Baro-o/Open-Salad-Mix/BOM list & 3D explosion view & Assembling/3D explosion view/opensalad_mix_cad_preliminary_a.png

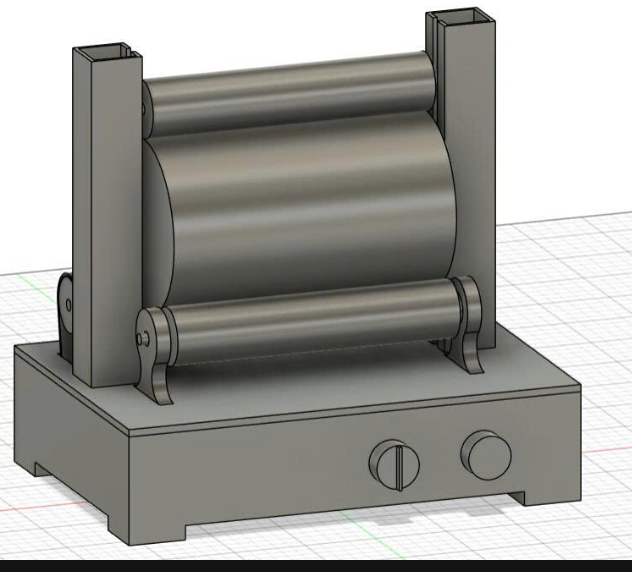
BOM list & 3D explosion view & Assembling/3D explosion view/opensalad_mix_cad_preliminary_a.png
