Baro-o/Open-Salad-Mix/BOM list & 3D explosion view & Assembling/BOM_Open_Salad_Mix_final_v2.pdf

### BOMOpen Salad Mix Rev:08.11.2026 By:Open Salad Mix team Rate:1 EUR = 28,672.48 VND

Part # | 3D view | Part name | Qty | Part size | Material / process / model | Source Type

Unit price
(EUR)

Total
(EUR)
A. 3D-printed parts (FDM)
P001 | Base Housing | 1 | Dimension: 320mm x 220mm x 75mm | Material: PETG / PETG-CF Process: 3D printed (FDM) Note: holes for selector, timer knob and cable | Designed | incl. | incl.
P002 | Deck Plate | 1 | Dimension: 320mm x 220mm x 5.5mm | Material: PETG / PETG-CF Process: 3D printed (FDM) Note: separate part; slots for lower roller position | Designed | incl. | incl.
P003 | Motor Holder | 1 | Dimension: 80mm x 40mm x 49mm | Material: PETG / PETG-CF Process: 3D printed (FDM) | Designed | incl. | incl.
P004 | Lower Bearing Holder | 4 | Dimension: 59mm x 50mm x 10mm | Material: PETG / PETG-CF Process: 3D printed (FDM) Bearing seat for 608-2RS 2 per lower roller | Designed | incl. | incl.
P005 | Upper Bearing Holder (long arm) | 2 | Dimension: 29.5mm x 29.5mm x 152.372mm | Material: PETG / PETG-CF Process: 3D printed (FDM) Note: rests directly on Slider Holder in open position, no separate latch | Designed | incl. | incl.
P006 | Spring Column / Slider Holder | 2 | Dimension: 52mm x 36mm x 225mm | Material: PETG / PETG-CF Process: 3D printed (FDM) Note: covers the extension spring | Designed | incl. | incl.
P007 | Roller Sleeve | 3 | Dimension: Φ40mm x 200mm | Material: TPU 95A Process: 3D printed (FDM) Colour: Green (as in CAD) | Designed | incl. | incl.
P008 | TPU Feet | 4 | Dimension: 42mm x 42mm x 11mm | Material: TPU 95A Process: 3D printed (FDM) Colour: Black | Designed | incl. | incl.
P009 | Control Knob (timer) | 1 | Dimension: Φ40mm x 20mm | Material: PETG / PETG-CF Process: 3D printed (FDM) Note: not listed separately in budget, confirm | Designed | incl. | incl.
P010 | PETG / PETG-CF filament | 1 | Allowance (lot) | For parts 1–6, 9 Supplier: FabLab / local | | 19.18 | 19.18

Part # | 3D view | Part name | Qty | Part size | Material / process / model | Source Type | Unit price (EUR) | Total (EUR)
P011 | | TPU 95A filament | 1 | Approx. 0.5 kg | For parts 7,8 Supplier: FabLab / local | | 7.67 | 7.67
Subtotal A (EUR) | | | | | | | | 26.86
B. Mechanical purchased parts
M001 | Stainless Shaft | 3 | Ø = 8mm L = 240mm / 255mm / 260mm (1 pc each) | Material: Stainless steel Process: cut and deburr | Hardware | 2.96 | 8.89
M002 | Bearing | 6 | Φ22 - Φ8mm Thickness = 7mm | Model: 608-2RS Note: 2 bearings per roller Source: thegioiic.com 608ZZ (metal-shield variant); (https://www.thegioiic.com/608zz-bac-dan-vong-bi-trong-8mm-ngoai-22mm-day-7mm) 2RS | Hardware | 0.84 | 5.02
M003 | GT2 Pulley 20T | 1 | Belt width = 6 Bore: Φ8mm | Mounted on motor Note: verify motor-shaft bore Source: linhkienx.com GT2 20T, 8 mm bore; (https://linhkienx.com/gt2-banh-rang-20-rang-buoc-2mm-truc-8mm-ranh-day-dai-7mm) | Hardware | 0.87 | 0.87
M004 | GT2 Pulley 60T | 1 | Belt width = 6 Bore: Ø8mm | Mounted on driven roller Source: sigmanortec.ro GT2 60T, 8 mm bore; (https://www.sigmanortec.ro/en/toothed-pulley-gt2-60-teeth-8mm) | Hardware | 2.41 | 2.41
M005 | GT2 Endless Belt | 1 | Width = 6mm Circumferenc e = 240mm | Source: no 240 mm closed-loop listing found; closest: thegioiic.com 2GT-280 (280 mm) (https://www.thegioiic.com/2gt-280-day-dai-140-rang-buoc-2-0-rong-6mm) | Hardware | 2.44 | 2.44
M006 | Extension Spring | 2 | Sold as pair | Model: ASRaymond T41270 Note: force and installed length require testing. | Sourced | 6.84 | 13.67
M007 | PET Jar | 2 | Ø120mm Height = 200mm | Material: PET, food contact Incl. cap / seal Note: 1 for the machine + 1 test sample Source: link to be added (no matching listing found yet) | Sourced | 3.49 | 6.98
M008 | Screw (pan-head, coarse thread) | 40 | Ø2.5mm Length = 12mm | Note: 30 required + 10 spare Pull-out test required | Hardware | 0.09 | 3.49
M009 | Misc. hardware set | 1 | Lot | Shaft spacers, set screws, washers, adhesive | Hardware | 4.19 | 4.19
Subtotal B (EUR) | | | | | | | 47.96
C. Electrical parts

Part # | 3D view | Part name | Qty | Part size | Material / process / model | Source Type | Unit price (EUR) | Total (EUR)
E001 | | Controller | 1 | | Model: Arduino Leonardo R3 (ATmega32U4) Source: hshop.vn original board (https://hshop.vn/products/arduino-leonardo-with-headers-chinh-hang-original-made-in-italy) | Hardware | 5.46 | 5.46
E002 | | Rotary Selector | 1 | | Type: 3-speed rotary selector Note: three operating-speed positions | Hardware | 4.19 | 4.19
E003 | | Rotary Timer Switch | 1 | | Type: physical rotary timer switch | Hardware | 6.28 | 6.28
E004 | | Motor | 1 | | Model: JGB37-520, 12 V, with encoder, 176 rpm Source: thegioiic.com JGB37-520 176 rpm (https://www.thegioiic.com/jgb37-520-dong-co-giam-toc-co-encoder-12vdc-176-rpm-truc-6mm) | Hardware | 6.98 | 6.98
E005 | | Motor Controller | 1 | | Model: IBT-2 / BTS7960 Source: thegioiic.com BTS7960 43A module (https://www.thegioiic.com/products/bts7960-module-dieu-khien-dong-co-dc-43a) | Hardware | 4.88 | 4.88
E006 | | Power Supply | 1 | | Model: MEAN WELL GST60A12-P1J 12 V, 5 A, 60 W | Hardware | 17.05 | 17.05
E007 | | Electrical Wire | 1 | L = 2000 | Note: only wire is retained, no connectors | Hardware | 2.44 | 2.44
E008 | | USB Cable | 1 | | For Arduino Leonardo Programming / data cable Source: hshop.vn Micro-USB cable 30 cm (https://hshop.vn/cap-micro-usb-to-usb-a-2-0-cable-30cm) | Hardware | 1.22 | 1.22
E009 | | Resistor 10 kΩ | 2 | 1/4 W, 5 %, axial | Value: 10 kΩ (brown-black-orange) Note: pull-up / pull-down for controller inputs Source: thegioiic.com 10 kΩ 1/4 W 5 % (https://www.thegioiic.com/dien-tro-10-kohm-1-4w-5-4-vong-mau) | Hardware | 0.02 | 0.04
Subtotal C (EUR) | | | | | | | | 48.54
TOTAL (EUR) | | | | | | | | 123.36
Budget (EUR) | | | | | | | | 200.00
Headroom (EUR) | | | | | | | | 76.64

## Reference views (CAD)

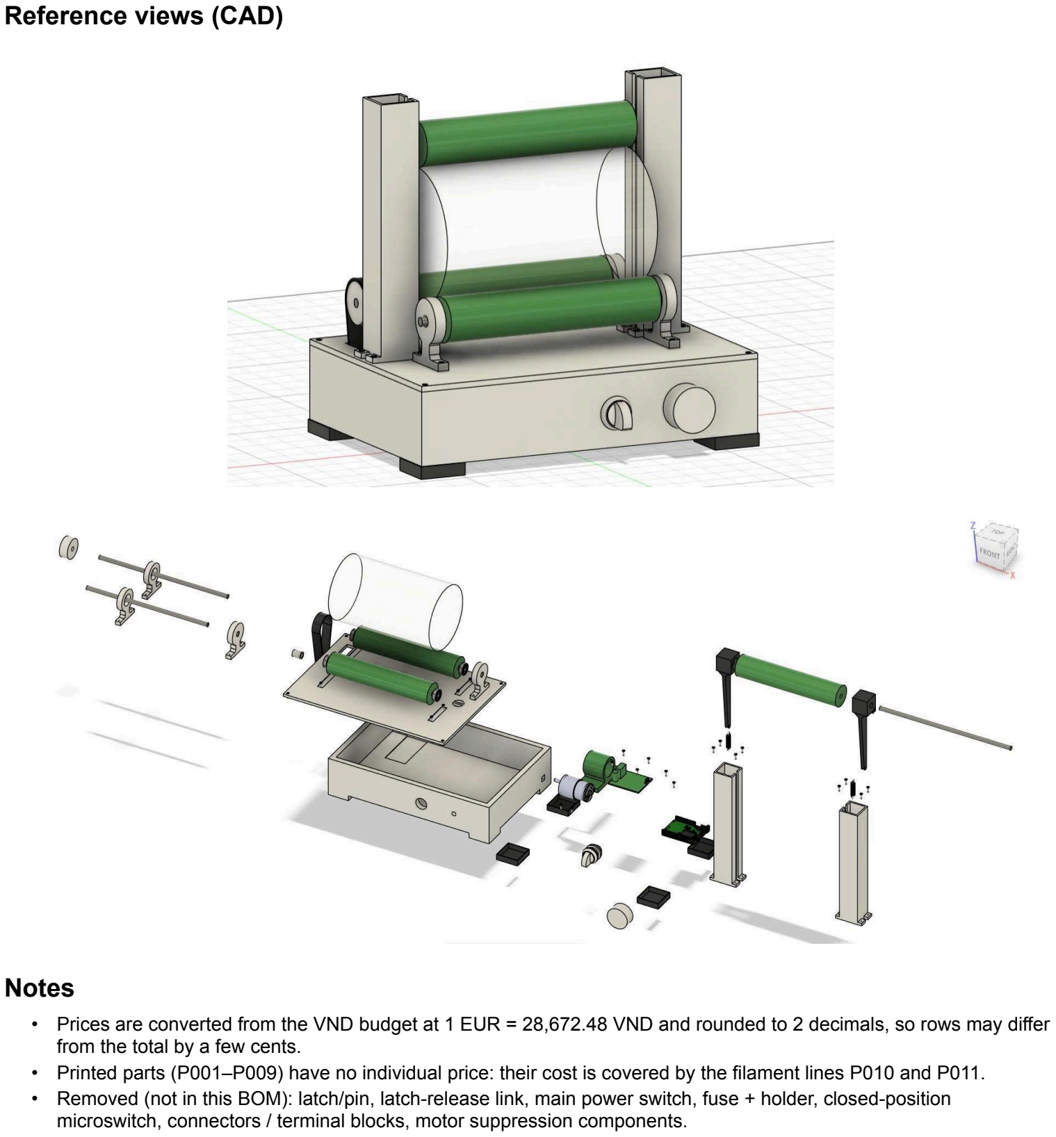
[picture p3: page 4]

## Notes

- Prices are converted from the VND budget at 1 EUR = 28,672.48 VND and rounded to 2 decimals, so rows may differ from the total by a few cents.
- Printed parts (P001–P009) have no individual price: their cost is covered by the filament lines P010 and P011.
- Removed (not in this BOM): latch/pin, latch-release link, main power switch, fuse + holder, closed-position microswitch, connectors / terminal blocks, motor suppression components.
