Baro-o/Open-Salad-Mix/BOM list & 3D explosion view & Assembling/3D explosion view/explore 4.jpg

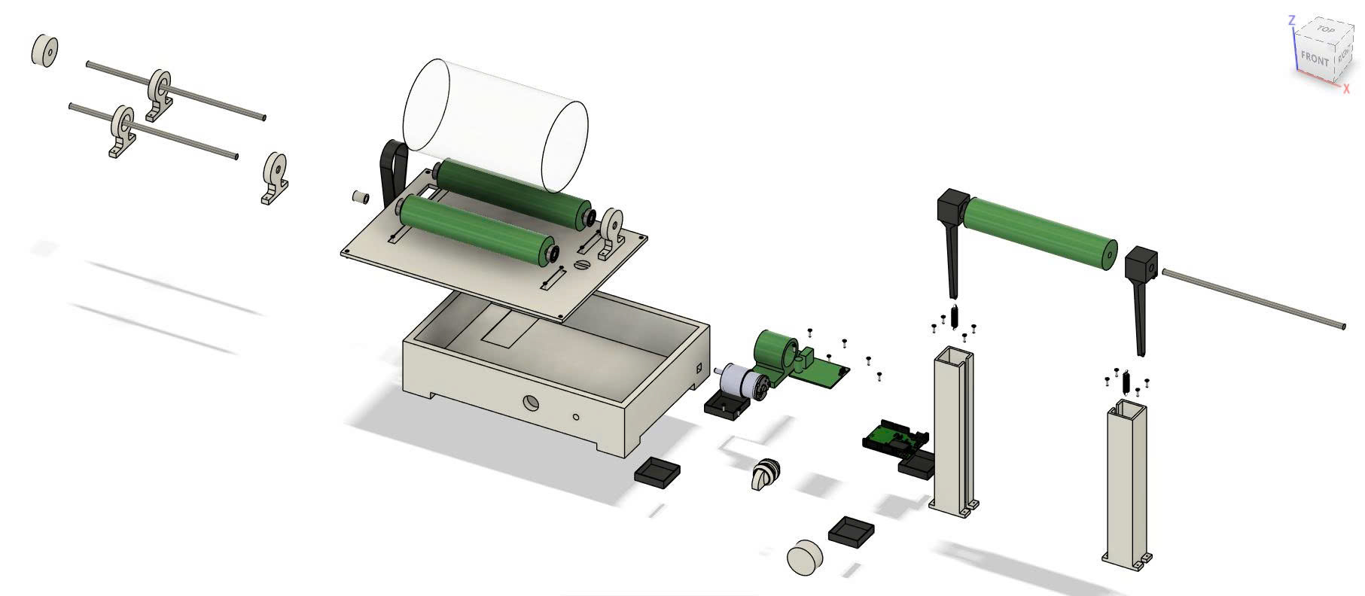
BOM list & 3D explosion view & Assembling/3D explosion view/explore 4.jpg
