Baro-o/Open-Salad-Mix/BOM list & 3D explosion view & Assembling/3D explosion view/explore 6.jpg

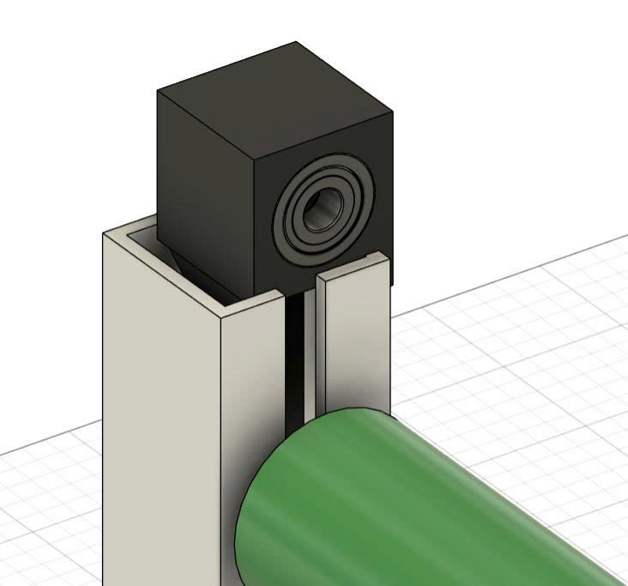
BOM list & 3D explosion view & Assembling/3D explosion view/explore 6.jpg
