Baro-o/Open-Salad-Mix/3D Model/Assembly.step

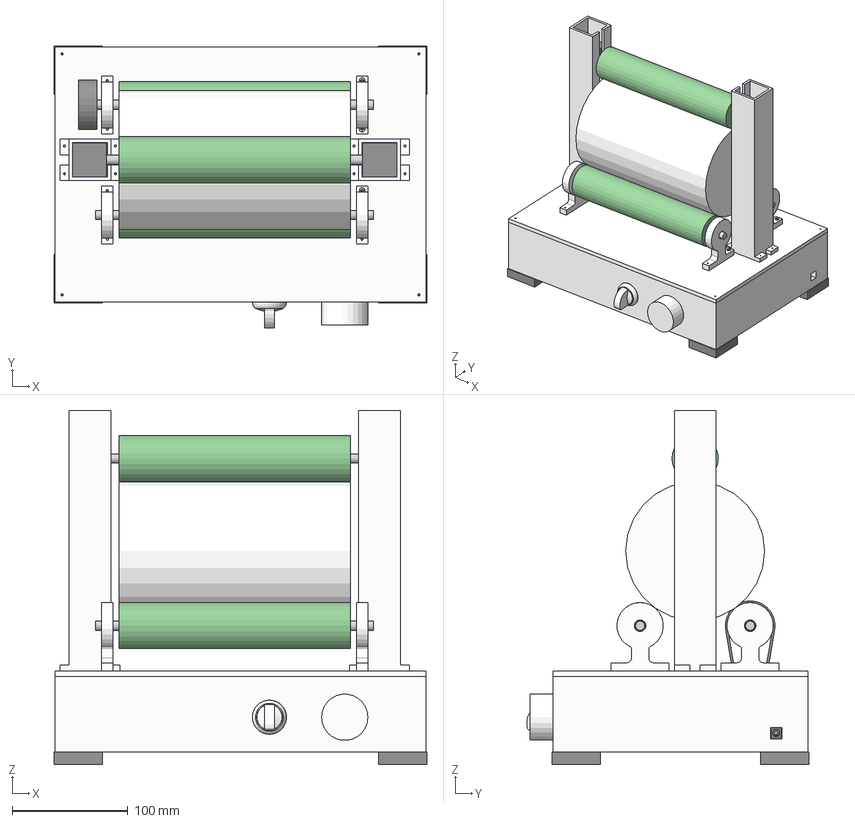
[picture p10: CAD file, 2026-11-08]
3D Model/Assembly.step
322.0 x 243.9 x 306.0 mm
looped_end_extension_spring_t41270
