Baro-o/Open-Salad-Mix/3D Model/3D print file.3mf

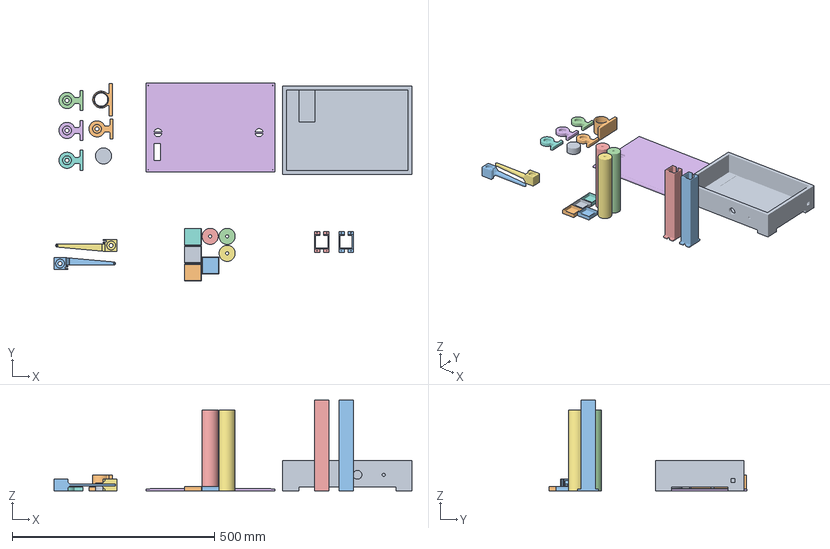
[picture p11: CAD file, 2026-11-08]
3D Model/3D print file.3mf
885.8 x 489.0 x 225.0 mm
Base and Electronic x 7
Clamping Roller Slide x 4
Bottom Roller x 7
OpenSalad Mix
