Baro-o/Open-Salad-Mix/3D Model/3D Print/P001_Base Housing.step

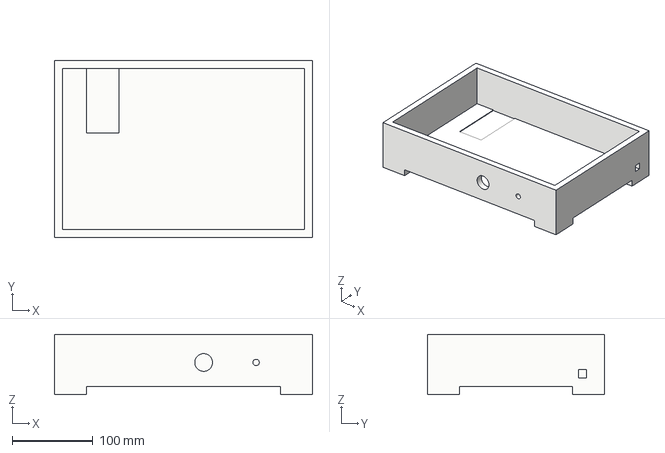
[picture p12: CAD file, 2026-11-08]
3D Model/3D Print/P001_Base Housing.step
320.0 x 220.0 x 75.0 mm
