Baro-o/Open-Salad-Mix/3D Model/Hardware/E001_Arduino Leonardo.step

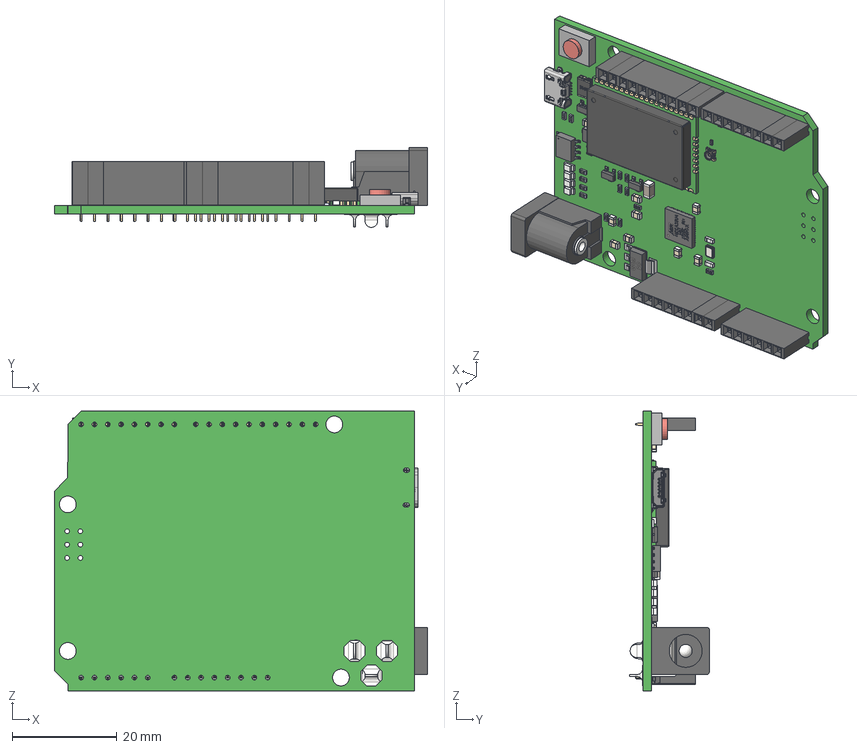
[picture p13: CAD file, 2026-11-08]
3D Model/Hardware/E001_Arduino Leonardo.step
71.1 x 15.2 x 53.3 mm
Extruded (1) x 6
Extruded x 6
Extruded (3)
Extruded (8) x 2
Extruded (9) x 3
Extruded (6) x 3
Extruded (10)
Extruded (13) x 11
User_Library-GeyerElectronics_KX6
Extruded (14)
Extruded (15)
Extruded (19)
Extruded (20) x 4
Extruded (21)
Extruded (2) x 5
Extruded (22)
Extruded (24)
RN2483
Atmega32U4-MU
nano - reg
THE THINGS UNO LED x 4
Arduino_uno_power jack
SOIC8-N_MC_MCH
micro USB
ssot3 x 4
HEADER 6 FEM x 4
HEADERFEMB x 8
Case x 12
Contacts x 12
Mid Body
Mark
R0603 10k ohm x 9
R0603 1k ohm x 4
1812_Fuse
R0603 22RO x 2
212(0805)-0850T x 2
316(1206)-1600T
