Baro-o/Open-Salad-Mix/3D Model/3D Print/P007_Roller Sleeve.step

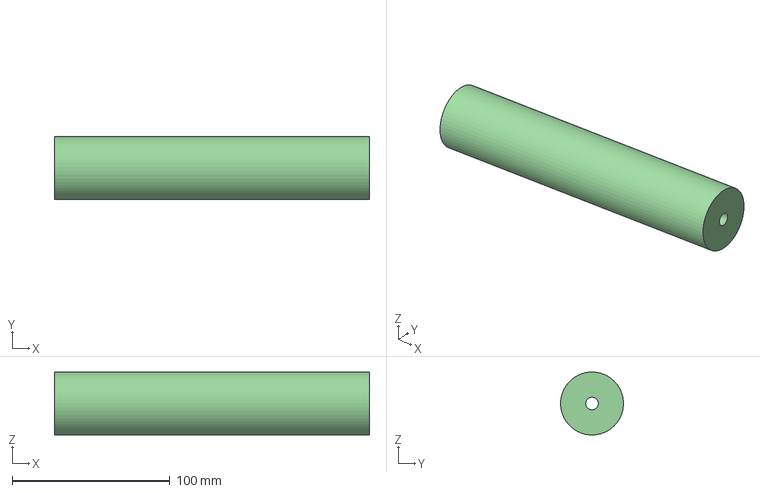
[picture p14: CAD file, 2026-11-08]
3D Model/3D Print/P007_Roller Sleeve.step
200.0 x 40.0 x 40.0 mm
