Baro-o/Open-Salad-Mix/3D Model/3D Print/P005_Upper Bearing Holder.step

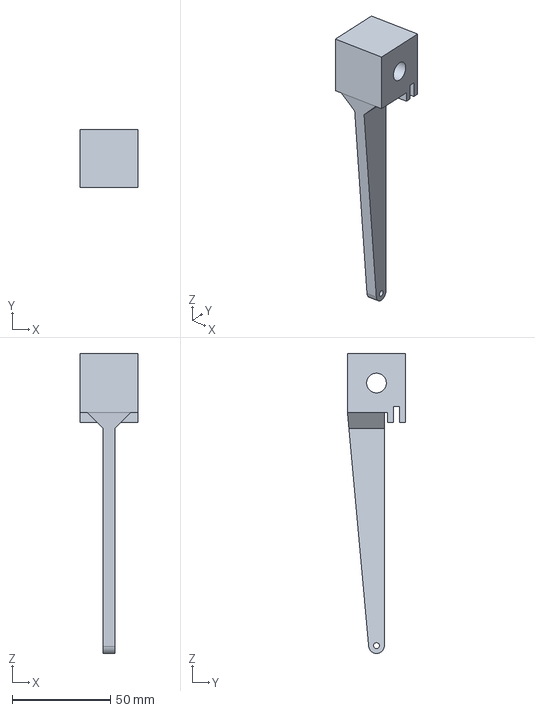
[picture p15: CAD file, 2026-11-08]
3D Model/3D Print/P005_Upper Bearing Holder.step
29.5 x 29.5 x 152.4 mm
