Baro-o/Open-Salad-Mix/3D Model/Hardware/M006_Looped_end_extension_spring_t41270.stp

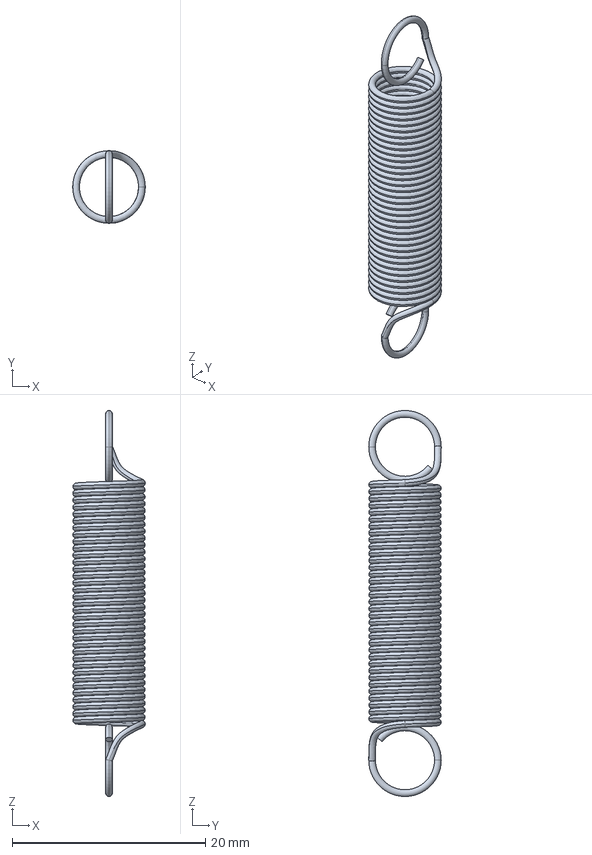
[picture p16: CAD file, 2026-11-08]
3D Model/Hardware/M006_Looped_end_extension_spring_t41270.stp
7.50 x 7.50 x 39.9 mm
