Baro-o/Open-Salad-Mix/3D Model/3D Print/P008_TPU Feet.step

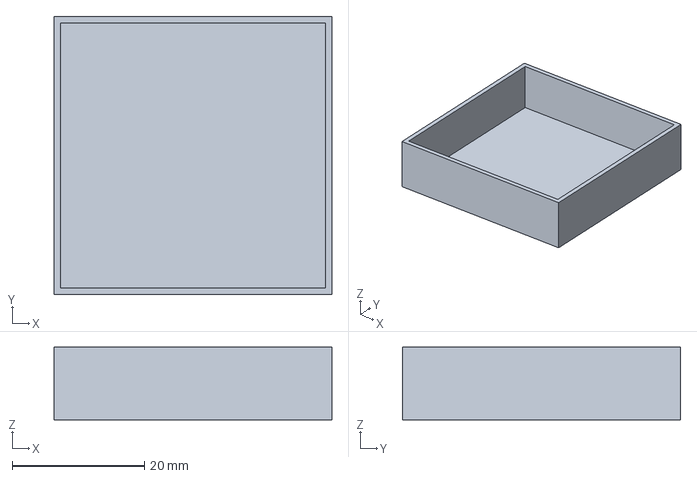
[picture p17: CAD file, 2026-11-08]
3D Model/3D Print/P008_TPU Feet.step
42.0 x 42.0 x 11.0 mm
