Baro-o/Open-Salad-Mix/3D Model/Hardware/M002_Bearing_608_2rs.stp

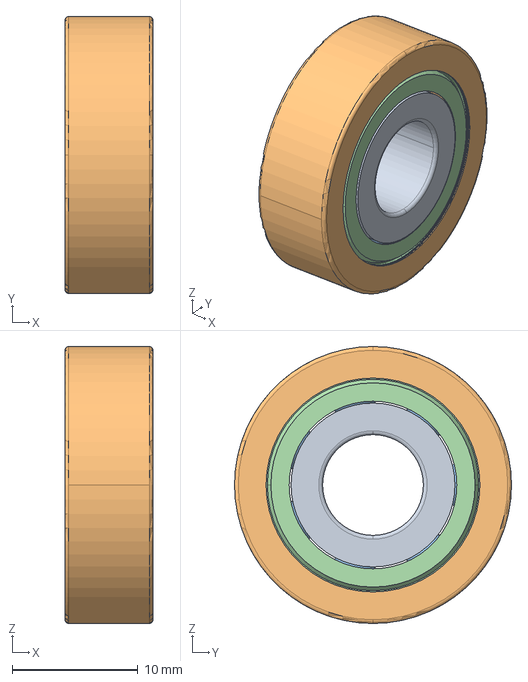
[picture p18: CAD file, 2026-11-08]
3D Model/Hardware/M002_Bearing_608_2rs.stp
7.00 x 22.0 x 22.0 mm
