Baro-o/Open-Salad-Mix/3D Model/3D Print/P009_Physical Rotary Timer Extension Knob.step

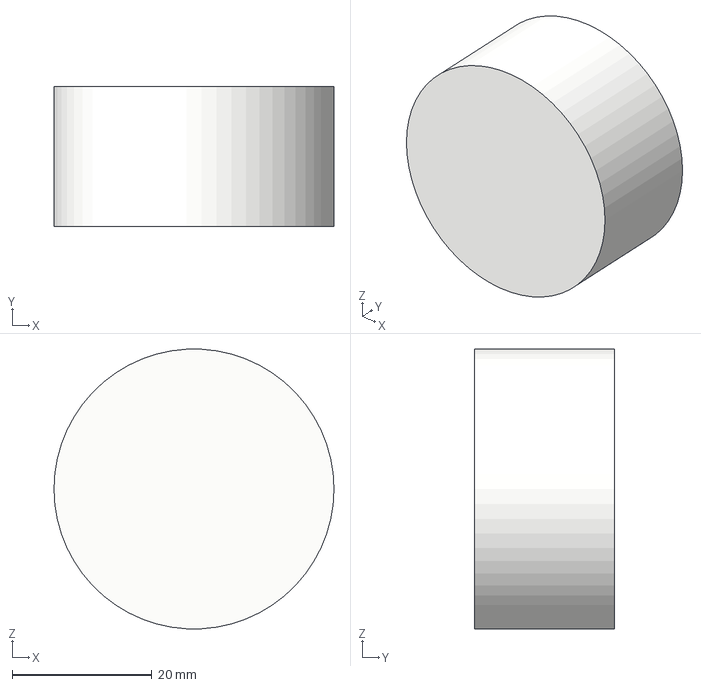
[picture p19: CAD file, 2026-11-08]
3D Model/3D Print/P009_Physical Rotary Timer Extension Knob.step
40.0 x 20.0 x 39.9 mm
