Baro-o/Open-Salad-Mix/3D Model/Hardware/E004_Motor JGB37-520.STEP

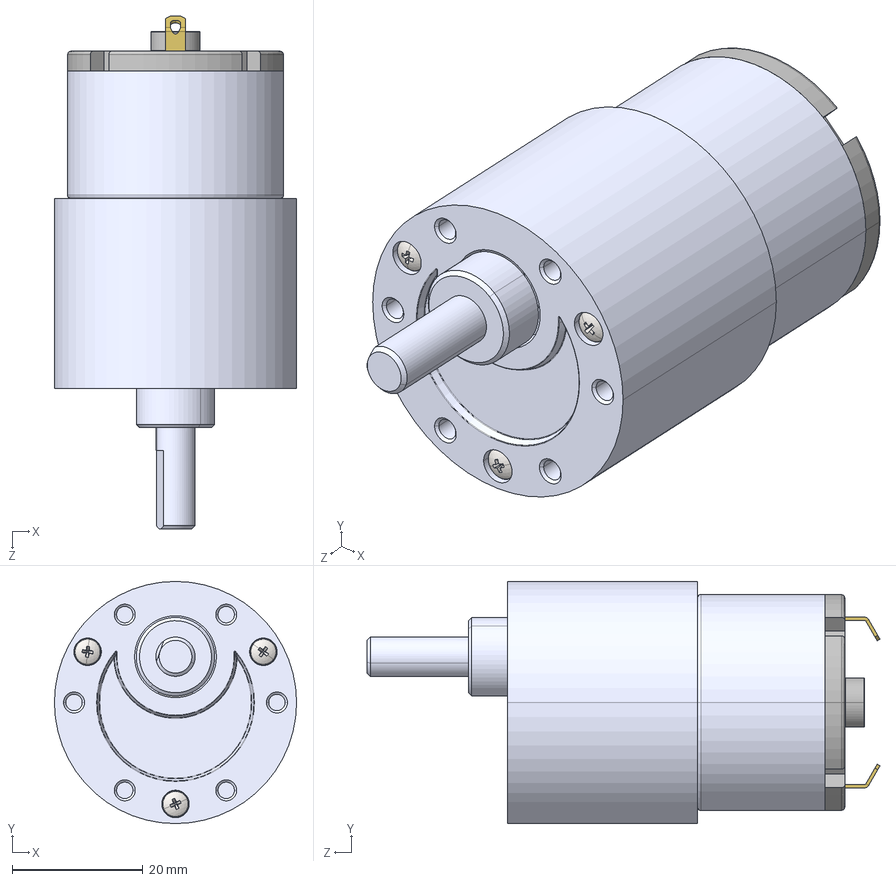
[picture p20: CAD file, 2026-11-08]
3D Model/Hardware/E004_Motor JGB37-520.STEP
37.0 x 37.0 x 78.4 mm
GEARED BODY, MOTOR, JGB37-520
DC MOTOR, JGB37-520
MOTOR SHAFT, JGB37-520
SHAFT COUPLER, JGB37-520
COUPLING BRACKET, GEARED BODY TO DC MOTOR, JGB37-520
PLASTIC COVER, DC MOTOR, JGB37-520
CONNECTION, DC MOTOR, JGB37-520 x 2
pan cross head_am_B18.6.7M - M2 x 0.4 x 25 Type I Cross Recessed PHMS --25N x 3
