Baro-o/Open-Salad-Mix/3D Model/3D Print/P003_Motor Holder.step

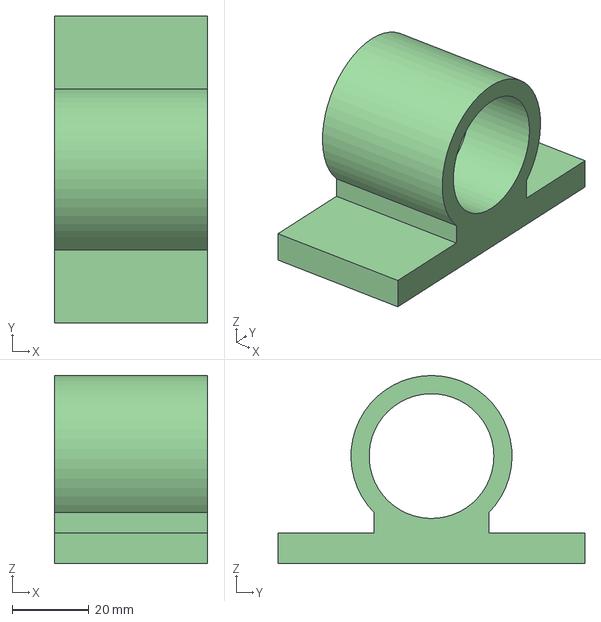
[picture p21: CAD file, 2026-11-08]
3D Model/3D Print/P003_Motor Holder.step
40.0 x 80.0 x 49.0 mm
