Baro-o/Open-Salad-Mix/3D Model/Hardware/E002_3 position Button.stp

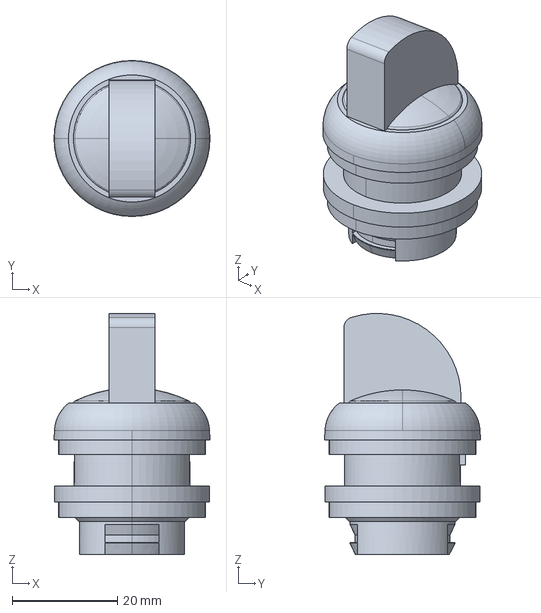
[picture p22: CAD file, 2026-11-08]
3D Model/Hardware/E002_3 position Button.stp
29.7 x 29.7 x 45.9 mm
