Baro-o/Open-Salad-Mix/3D Model/3D Print/P006_Slider Holder.step

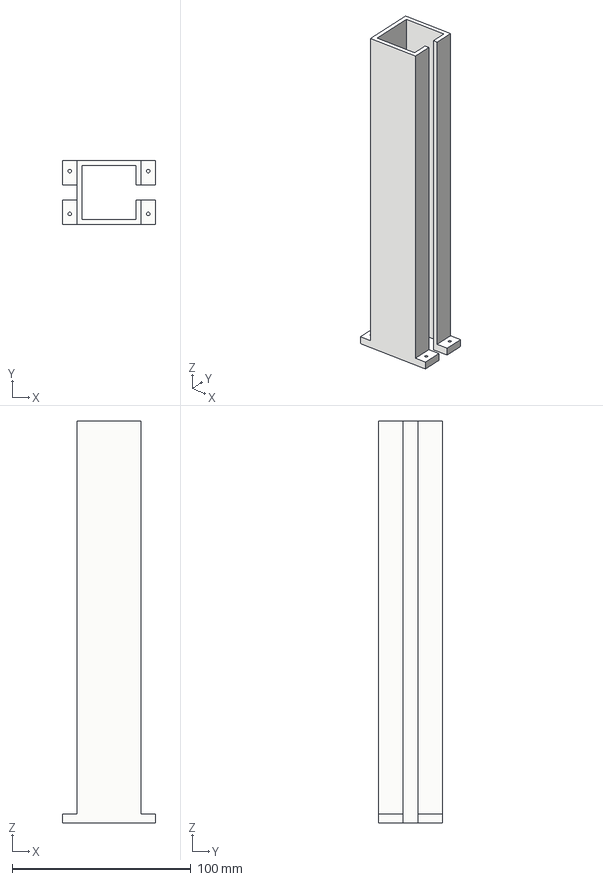
[picture p23: CAD file, 2026-11-08]
3D Model/3D Print/P006_Slider Holder.step
52.0 x 36.0 x 225.0 mm
