Baro-o/Open-Salad-Mix/3D Model/3D Print/P004_Lower Bearing Holder.step

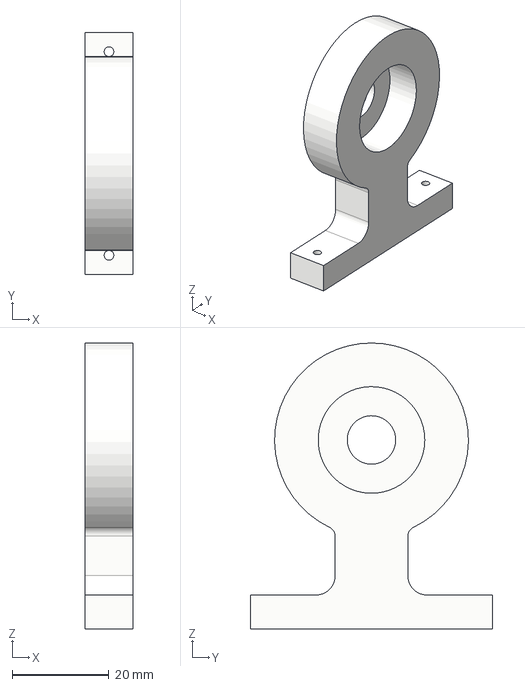
[picture p24: CAD file, 2026-11-08]
3D Model/3D Print/P004_Lower Bearing Holder.step
10.0 x 50.0 x 59.0 mm
