Baro-o/Open-Salad-Mix/3D Model/3D Print/P002_Deck Plate.step

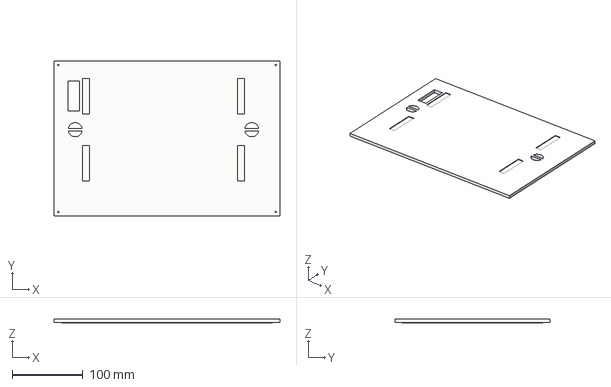
[picture p25: CAD file, 2026-11-08]
3D Model/3D Print/P002_Deck Plate.step
320.0 x 220.0 x 5.50 mm
