Baro-o/Open-Salad-Mix/3D Model/Hardware/M008_Pan Head Screw.stp

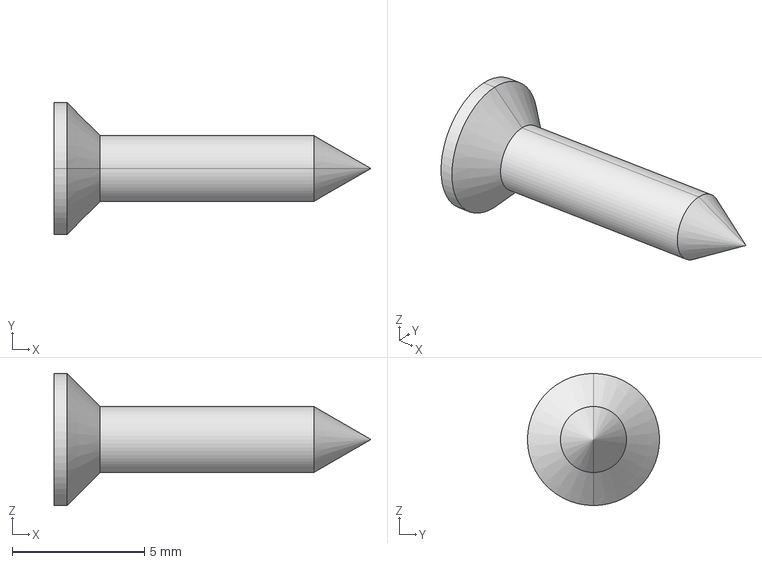
[picture p26: CAD file, 2026-11-08]
3D Model/Hardware/M008_Pan Head Screw.stp
12.0 x 5.00 x 5.00 mm
