Baro-o/Open-Salad-Mix/(list of files, cad)

Other CAD files:
3D Model/Assembly.f3z
