Baro-o/Open-Salad-Mix/Open_Salad_Mix_User_Guide.pdf

## open salad mix

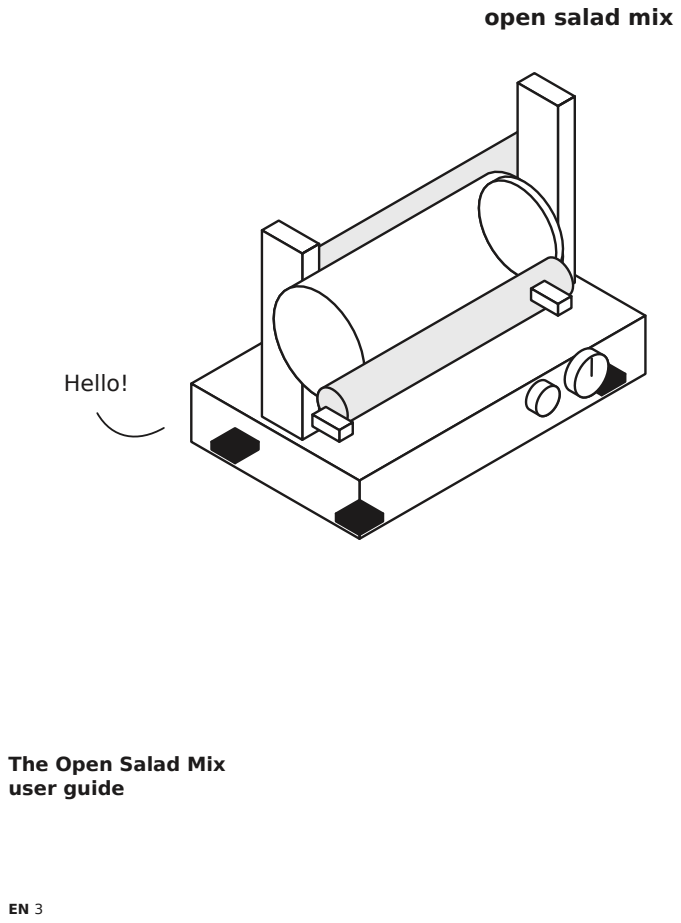
[picture p27: page 1]
Hello!

The Open Salad Mix
user guide

EN | Jar

Table of contents

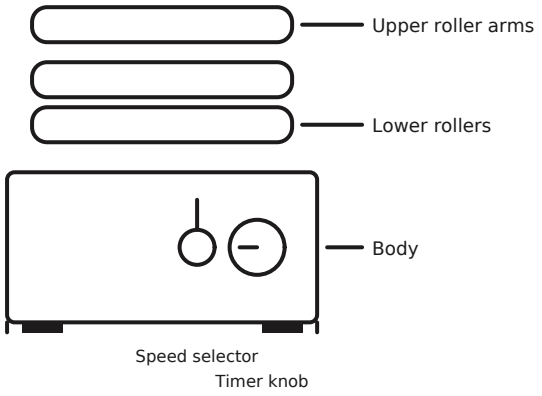
[picture p28: figure]
Upper roller arms; Lower rollers; Body; Speed selector; Timer knob

1. Important safety information | 4
2. Before using Open Salad Mix | 5
3. Using your Open Salad Mix | 7
4. Inside your Open Salad Mix | 12
5. Keeping Open Salad Mix in the loop 13
6. Technical and warranty | 14

IMPORTANT
Please read this user manual carefully before you use the appliance and save it for future reference.

In the box
Body • Jar with lid (PET, food contact) • 12 V power adapter • USB cable (for programming only) • User manual

EN 3

1. Important safety information | !

WARNING
- Always use the appliance in

accordance with these instructions. Improper use can result in electric shocks and other hazards.
- Do not use a jar if you detect cracks,

deep scratches, cloudiness or any damage to the plastic.
- Never fill the jar above the fill line

marked on it or with ingredients hotter than 40 °C, or with carbonated or fermenting ingredients (e.g. baking soda, baking powder, yeast).
- Always close the jar with its lid before

placing it on the rollers.
CAUTION
- Never leave the Open Salad Mix

unattended while it is in use.
- Always unplug the power adapter when

not in use.
- Pinch hazard: keep fingers, hair and

loose clothing away from the rollers, the belt and the upper roller arms while the machine is running.
- Lift and lower the upper roller arms

only when the machine is switched off and has completely stopped.
- Switch off and unplug the appliance

before leaving it unattended, assembling, disassembling or cleaning it.

Intended use
and users
- This appliance is intended for

household use to tumble and mix salads, dressings and similar food inside a closed jar.
- It is not intended for crushing, grinding

or blending hard ingredients, nor for professional use.
- Appliances may be used by persons

with limited physical, sensory or mental capabilities and persons lacking experience and/or knowledge if they are supervised or have received instruction regarding safe use of the appliance and understand the resulting hazards.
- This appliance must not be used by

children. The appliance and its power cable must be kept out of the reach of children. Children must not play with the appliance.

4 EN

# 2. Before using Open Salad Mix

Unboxing
- Open the box and take out the items.
- Clean any packaging remainings that

might have stayed on these parts, using a moist cloth.
- Do not use the product if damaged

after unpacking.
Power supply
- Use only the supplied 12 V DC adapter

(12 V, 5 A, 60 W). Check that the adapter’s input voltage matches your local mains voltage before you connect it.
- Only connect the adapter to wall

sockets that have been installed pursuant to regulations. Cable and plug must be dry.
- Do not pull or clamp the cable over

sharp edges. Do not leave it dangling and protect it from heat and oil.
- Do not immerse the body, adapter,

cable or plug in water or any other liquid.
- Never pull the plug out of the socket by

the cable or with wet hands.

Setup
- Before you use the appliance for the

first time, thoroughly clean the jar and the parts that come into contact with food.
- Place the body on a flat, dry, stable

surface. The four feet must stand fully on the surface.
- Make sure the speed selector points to

position O (= OFF) before you place the jar.
- Do not switch on the appliance without

a jar.
- Do not place the appliance on hot

surfaces, such as hotplates, and do not operate near naked flames.
- Store the appliance in a dry place.

12 V DC

EN 5

# Compatible jar

Use only one jar at a time: the food-contact PET jar supplied in the box (Ø 120 mm, 200 mm long). Open Salad Mix is designed and tested for this jar only. Do not use jars of other sizes or shapes, and never place more than one jar on the rollers.

!

Do not use a jar if you detect cracks, deep scratches, cloudiness or damage to the plastic, as this could create safety hazards.

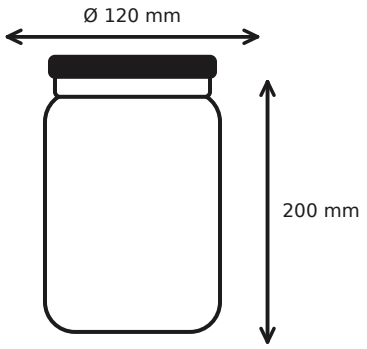
[picture p29: figure]

- Using any jar other than the supplied one may damage your Open Salad Mix or

create safety hazards.
- Check that the lid is tight and the seal is seated and undamaged before every use.
- Check that the jar rotates freely on the rollers before switching on.

Jar fit
If the jar slips or does not turn, check that it is centred between the two lower rollers and that the upper roller rests on it. If this does not help, contact customer support. Do not replace the jar with another one.

6 EN

# 3. Using your Open Salad Mix

Use your Open Salad Mix to tumble and mix a variety of salads and dressings. Once you have a recipe in mind, close the jar and let the rollers do the work.

Green salads

Pasta salads

Coleslaw

Grain bowls

Dressings

Marinades

Fruit salads

Herbs & seasonings

## Control

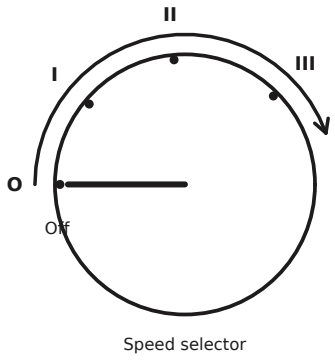
[picture p30: figure]
III; Off; Speed selector

Always start with the speed selector in position O (OFF). Use I, II and III to choose the rolling speed. Turn the timer knob to set how long the machine runs; it stops automatically when the time is over.

Start with a low speed for light leafy salads and use a higher speed for heavier mixtures.

Timer knob

EN 7

# How to use

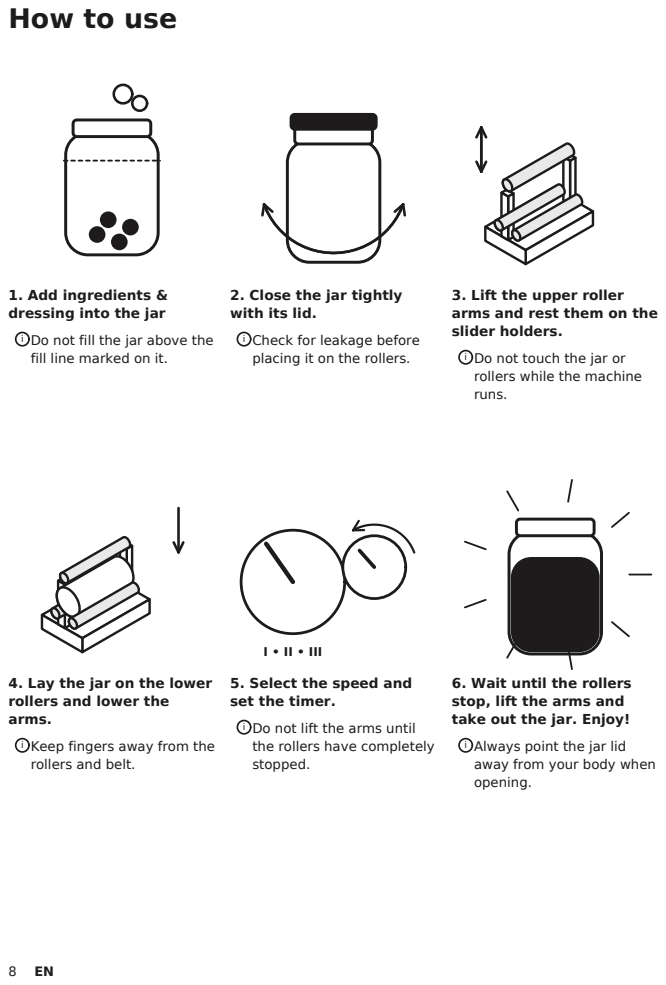
[picture p31: page 8]
I • II • III

1. Add ingredients &
dressing into the jar

2. Close the jar tightly
with its lid.

3. Lift the upper roller
arms and rest them on the
slider holders.

i Do not fill the jar above the
fill line marked on it.

i Check for leakage before
placing it on the rollers.

i Do not touch the jar or
rollers while the machine
runs.

4. Lay the jar on the lower
rollers and lower the
arms.

5. Select the speed and
set the timer.

6. Wait until the rollers
stop, lift the arms and
take out the jar. Enjoy!

i Do not lift the arms until
the rollers have completely
stopped.

i Keep fingers away from the
rollers and belt.

i Always point the jar lid
away from your body when
opening.

# Safety first

DO NOT
USE

Do not use a damaged
jar.

MAX
fill line

Do not fill the jar
above the fill line
marked on it.

MAX
40 °C

Never fill the jar with
ingredients hotter
than 40 °C.

LID
CLOSED

Always close the jar
with its lid.
- Never leave the Open Salad Mix

unattended while in use.
- Inspect the jar before every use. Hold it

up to the light to spot cracks, deep scratches, cloudiness or damage.
- Stop using a damaged jar, as it can

leak or break during use.
- Keep fingers, hair and clothing away

from the rollers, belt and moving arms.
- Switch off the appliance and unplug it

before cleaning, or before touching any moving part.
- Never operate the appliance with the

cover or any part removed.

- If the jar is not sitting properly on the

rollers, stop immediately, unplug the appliance and reposition the jar.
- If you hear grinding noises or notice a

pungent smell or smoke, stop and unplug the appliance. Let it cool down for 15 minutes.
- If the motor stops working, unplug the

adapter and let it cool for an hour before attempting to use it again.
- Do not run the appliance continuously

for long periods; let it rest between batches.
- The belt and the springs of the upper

roller arms are wear parts. Inspect them regularly.

EN 9

Things you shouldn’t mix
- Do not put carbonated or fermenting

ingredients (e.g. baking soda, baking powder, yeast) in the closed jar. Pressure can build up and cause injury.
- Do not use very hard or sharp

ingredients (e.g. bones, large ice blocks) that could damage the jar.
- Do not let prepared salads sit in the jar

on the machine for long periods of time.

Tips for mixing
- For best results, fill the jar only up to

the fill line marked on it and leave space for the ingredients to tumble.
- Add dressing last, just before mixing,

so that delicate leaves stay fresh.
- If the ingredients clump together, stop,

open the jar, stir with a spoon and mix again.
- If you prepare multiple batches, let the

appliance rest between batches.

## Cleaning & care

- After using Open Salad Mix, clean all surfaces and parts that have come into contact

with food using a brush or sponge.
- Clean the body and the rollers with a moist cloth. Never immerse the body in water.

Cleaning & care > Jar

Handwash the jar and lid with warm soap water.

40°

Do not use hot water above 40 °C on the PET jar.

Avoid hits to the jar from dishes or other objects.

Avoid hits to the jar from metal utensils such as spoons.

10 EN

Cleaning & care > Rollers & arms

Do not put the body or the rollers in the dishwasher.

Wipe the roller sleeves with a moist cloth.

Do not soak the rollers or the belt in water.

To clean the roller more thoroughly, unplug the appliance, then disassemble and clean each part individually, as shown below.

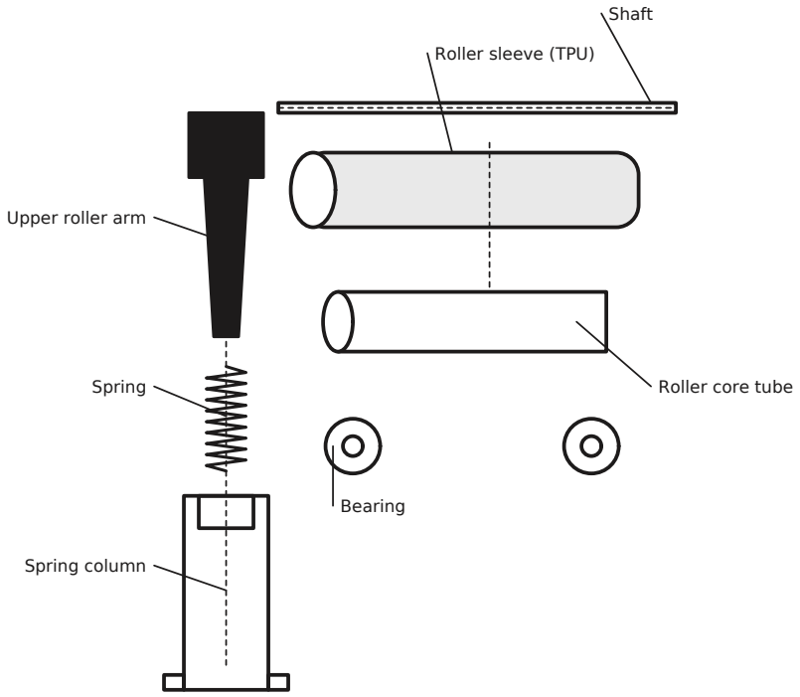
[picture p32: figure]
Spring; Upper roller arm; Spring column; Bearing; Roller sleeve (TPU); Shaft; Roller core tube

### 1. Remove the upper roller

Lift the arm, unhook the spring and slide the roller out of the arm.

### 2. Remove the roller sleeve

Pull the TPU sleeve off the roller core. Pay attention not to damage it.

### 3. Clean the parts

Wipe the sleeve, shaft and arm with a moist cloth.

To put the parts back, redo the steps in the reverse order.

EN 11

Starting issues
If the appliance does not start or the jar does not turn, try the following:
- Check that the adapter is plugged in and the speed selector is not in position O.
- Check that the timer knob is not set to zero.
- Check that the jar sits between the two lower rollers and the upper roller rests on it.
- Make sure you are using the original jar provided with your Open Salad Mix.

# 4. Inside your Open Salad Mix

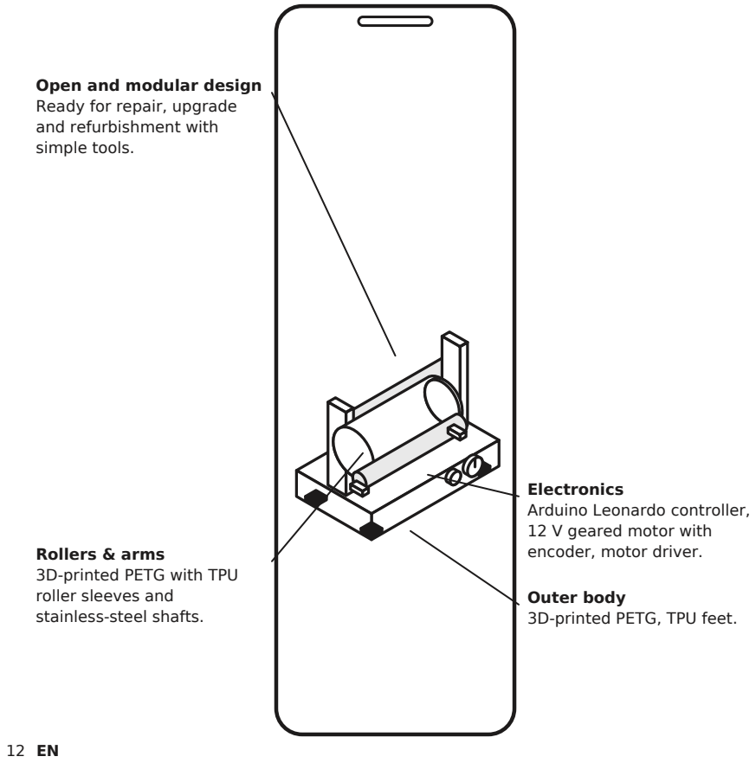
[picture p33: figure]
Open and modular design Ready for repair, upgrade and refurbishment with simple tools.; Rollers & arms 3D-printed PETG with TPU roller sleeves and stainless-steel shafts.; Electronics Arduino Leonardo controller, 12 V geared motor with encoder, motor driver.; Outer body 3D-printed PETG, TPU feet.

## 5. Keeping Open Salad Mix in the loop

We’ve laid the groundwork for a durable product, and now it is your turn to make the loop work. This means taking care of your Open Salad Mix, repairing it when needed, and eventually returning it so it can be refurbished and recycled. Circular economy, here we come!

Sourcing | Assembly | Use
Recycling | Return & refurbish | Care & repair

### 1. Repair

- If the device breaks, try repairing it

yourself (or someone with more technical experience).
- If the power adapter or cable is

damaged, replace it with an identical one.
- Periodically inspect all components, the

belt and the springs for damage or wear. Assure that the power cord and plug are undamaged.
- Never operate your Open Salad Mix

with damaged jars or components. If it malfunctions in any way, immediately discontinue use.

### 2. Return & refurbish

Shall you not need your Open Salad Mix anymore, pass it on to a new user. Components that cannot be reused should be sent to an appropriate recycler or waste collector.

### 3. Recycling

If for any reason you do not want to keep the product, you can dispose of it according to the local legislation of your country. Please try to reuse or resell working components, separate materials and find local recycling partners.

EN 13

### 6. Technical & warranty

- Supply: 12 V DC, 5 A, 60 W power

adapter
- Motor: 12 V DC geared motor with

encoder
- Controller: Arduino Leonardo
- Speeds: 3 selectable speeds + timer
- Dimensions of body

(height/depth/width): [to be added]
- Weight of body/ jar: [to be added]

At the end of its life, this product may not be disposed of in normal household waste, but must instead be taken to a collection point for recycling electrical and electronic appliances. If you need more information, please contact your local waste administration.

Warranty
Warranty terms: [to be added by the manufacturer]

Subject to change.

Contact
hloan114@gmail.com

14 EN

## open salad mix

# Have fun!

Contact
hloan114@gmail.com

User guide 1.0 • November 2026
