Baro-o/Open-Salad-Mix/src/Wiring Diagram.jpg

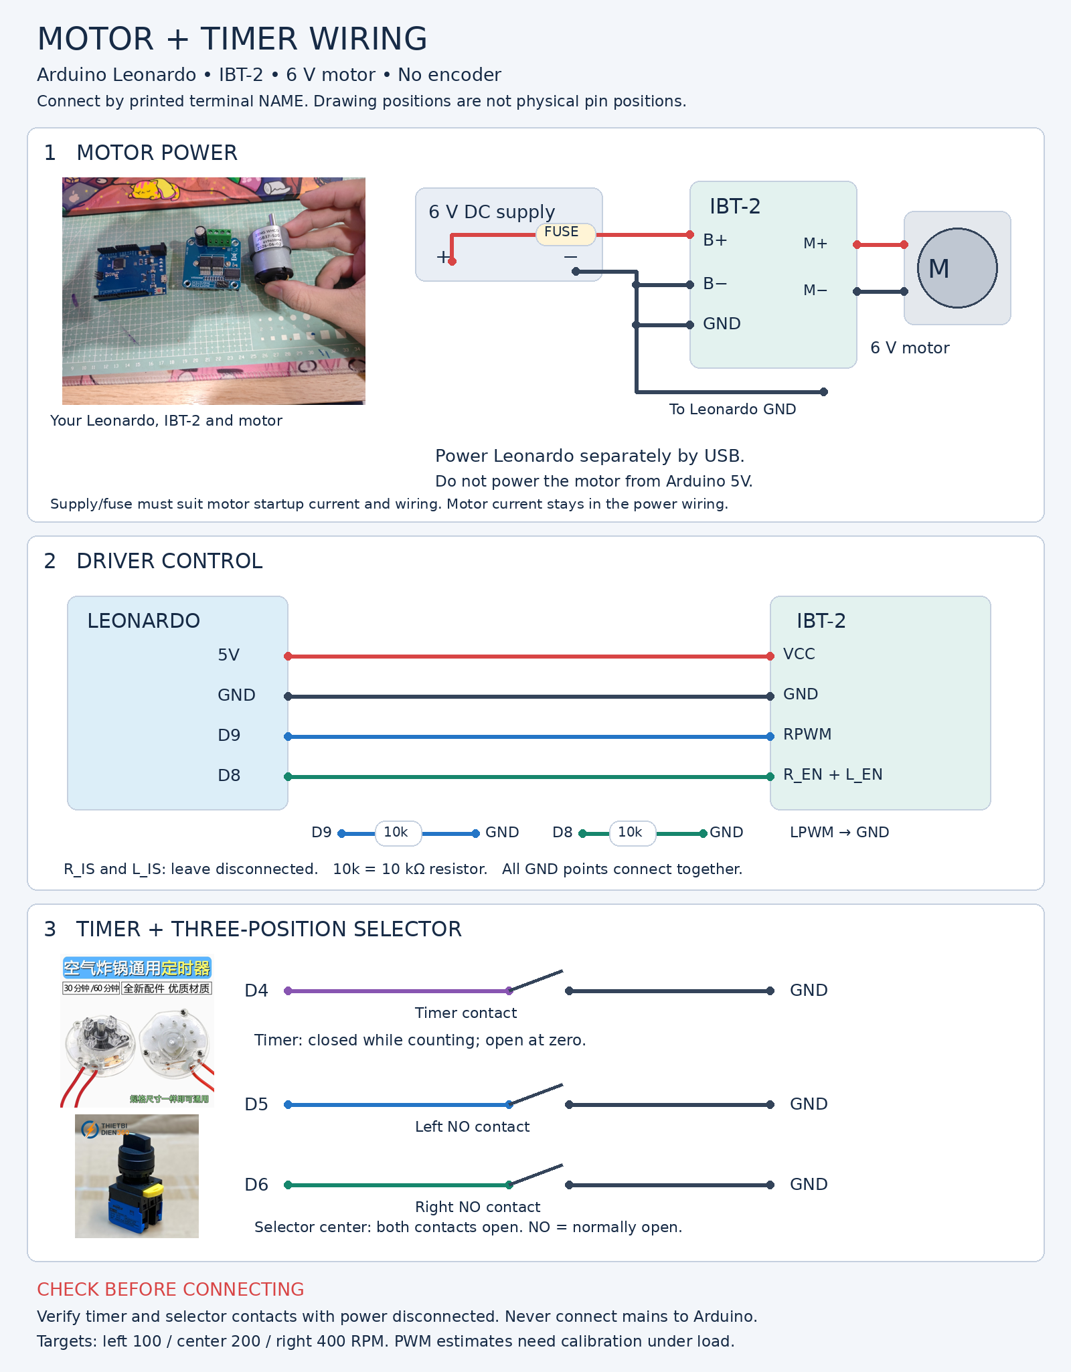
src/Wiring Diagram.jpg
