Baro-o/Open-Salad-Mix/(commit log)

2026-11-08 Add hardware 3D files
    [E-002_3 position Button.stp, E-004_JGB37-520.STEP, M-002_Bearing_608_2rs.stp, M-011_Looped_end_extension_spring_t41270.stp, M-013_Pan Head Screw.stp]
2026-11-08 Add 3D Printed components
    [Assembly.step, M-001_Bottom base.step, M-001_Deck Plate.step, M-001_Lower Bearing Holder.step, M-001_Motor Holder.step, M-001_Physical Rotary Timer Extension Knob.step, M-001_Slider Holder.step, M-001_Upper Bearing Holder.step]
2026-11-08 Change code name for 3D model step
    [Assembly.f3z, E001_Arduino Leonardo.step, E002_3 position Button.stp, E003_JGB37-520.STEP, M002_Bearing_608_2rs.stp, M006_Looped_end_extension_spring_t41270.stp, M008_Pan Head Screw.stp, P001_Bottom base.step]
2026-11-08 add wiring and code
    [3D print file.3mf]
2026-11-08 Add BOM list
2026-11-08 Change file name to match BOM
    [E004_Motor JGB37-520.STEP, P001_Base Housing.step, P008_TPU Feet.step]
